FH-raidonn/LR_Furukawa/README.md

LR_Workのフォルダ内にRDACのデータが入っています。
末尾の数字が多いほうが最新版です

現在の最新版(LR_Work5/RDAC_0128)
