FH-raidonn/LR_Furukawa/LR_Work3/Report_1003/ミニマルアルバイト課題_目標値追記_Furukawa.pptx

9月度アルバイト内容
１．(抵抗ラダー、キャパシタタイプ14bitDAC)+ボルテージフォロアーアンプ回路設計、シミュレーション
TOOL：回路設計⇒Xschem or LTSPICE、シミュレーション⇒NGSPICE or LTSPICE
目標仕様：変換速度 10MSPS
SPICEモデル：N3(3V Nch), P3(3V Pch)
抵抗情報:2kΩ/um²　or 350Ω/um² ,0.08fF/um²
キャパシター情報:1.32ff/um², 80Ω/um²
納品物：Xschemのデータとシミュレーション報告書(フォーマットは、自由)及びデータシート
納期：10月3日
担当者：野田さん、古川さん

入力・出力信号情報
VDD:3.3V±10%、VSS:0V
VREFH:VDD、Vrefl:VSS、入力範囲:VSS～VDD
DIN[13:0]:VIL=VDDx0.2, VIH=VDD*0.8, trise=tfall=1ns
DACO=(Vrefh-Vrefl)/16384 x din(バイナリ値)
PD:PD=VILでパワーダウンモード
Iref:10uAのバイアス電流源
VOUT:DACOをボルテージフォロアアンプを経由した出力
din⇒dout出力遅延時間:90ns max
vm=VDD/16384
【タイムチャート】以下参照

din[14’h0000]

din[14’h3fff]

din[14’h1fff]

din[14’h0fff]

din[14’h1111]

不定

dout=0

不定

dout=VDD

不定

dout=vm*8192

不定

dout=vm*4096

不定

dout=vm*4369

<90ns

100ns

<90ns

100ns

<90ns

100ns

<90ns

100ns

<90ns

100ns

## Slide 2

データシートのフォーマット

DAC部(VDD=3.3V, VSS=0V)
項目 | Symbol | 条件 | | 目標値 | typ | ワースト | 単位
INLエラー | INL | データ=x0000-x3ffff | | ±2 | +1.26 | | LSB
DNL | DNL | データ=x0000-x3ffff | | ±1 | +1.61 | | LSB
オフセットエラー | Vos | VIN=0x0000 | | 5 | ほぼ0% | | %of FSR
Gain エラー | gE | VIN=0x3fff | | 5 | 0.05 | | %of FSR
消費電流 | IDD | VIN=0x3FFF, PD=VIH, f=10MHz* | | 5 | 0.108 | | mA
スタンバイ電流 | IDDS | PD=VIL | | 100 | 26.181 | | uA
ボルテージフォロワーアンプ部(VDD=3.3V, VSS=0V)
出力電圧範囲 | VOUT | | VREFH-VREFL | | 59.9n~3.16 | | V
位相裕度 | Φ | | 90 | | 33.8 | | °
Slew Rate | SR | RL=1MΩ, CL=1pF | 0.1 | | 2.29 | | V/us
出力電流 | IOUT | CL=1pF | 1 | | 0.78 | | mA

ブロック図

f=DINのサイクル周波数

抵抗ラダー、キャパシタタイプ DAC

ボルテージフォロワーアンプ

DIN[13:0]

DACO

+

VOUT

Ibias

PD
