FH-raidonn/LR_Furukawa/LR_Work4/Review_1112/RDAC報告_1112.pptx

## RDAC 10月分

古川 大鷹

## Slide 2

10月度アルバイト内容
１．(抵抗ラダー、キャパシタタイプ12bitDAC)+ボルテージフォロアーアンプ回路設計、シミュレーション
TOOL：回路設計⇒Xschem or LTSPICE、シミュレーション⇒NGSPICE or LTSPICE
目標仕様：変換速度 10MSPS(最悪 5MSPS)
SPICEモデル：N3(3V Nch), P3(3V Pch)
抵抗情報:2kΩ/um²　or 350Ω/um² ,0.08fF/um²
キャパシター情報:1.32ff/um², 80Ω/um²
納品物：Xschemのデータとシミュレーション報告書(フォーマットは、自由)及びデータシート
納期：10月31日
担当者：野田さん、古川さん

入力・出力信号情報
VDD:3.3V±10%、VSS:0V
VREFH:VDD、Vrefl:VSS、出力範囲:VSS+0.7～VDD-0.7
DIN[11:0]:VIL=VDD*0.2, VIH=VDD*0.8, trise=tfall=1ns
DACO=(Vrefh-Vrefl)/4096 x din(バイナリ値)
PD:PD=VILでパワーダウンモード
Iref:±10uAのバイアス電流源
VOUT:DACOをボルテージフォロアアンプを経由した出力
din⇒dout出力遅延時間:90ns max
vm=出力範囲/4096
【タイムチャート】以下参照

9月の課題からの変更点
・DACのビット数（14→12)
・出力範囲（Rail to Rail→緩和）
・変換速度の最悪値

din[12’h0000]

不定

dout=0

din[12’hf1ff]

不定

dout=vm*1ff

din[12’hfff]

不定

dout=vm*fff

din[12’h0ff]

不定

dout=vm*0ff

din[12’h111]

不定

dout=vm*111

<90ns

100ns

<90ns

100ns

<90ns

100ns

<90ns

100ns

<90ns

100ns

## Slide 3

データシートのフォーマット

DAC部(VDD=3.3V, VSS=0V)
項目 | Symbol | 条件 | | 目標値 | typ | ワースト | 単位
INLエラー | INL | データ=x000-xfff | | ±2 | | | LSB
DNL | DNL | データ=x000-xfff | | ±1 | | | LSB
オフセットエラー | Vos | VIN=x000 | | 5 | | | %of FSR
Gain エラー | gE | VIN=xfff | | 5 | | | %of FSR
消費電流 | IDD | VIN=xfff, PD=VIH, f=10MHz* | | 5 | | | mA
スタンバイ電流 | IDDS | PD=VIL | | 100 | | | uA
ボルテージフォロワーアンプ部(VDD=3.3V, VSS=0V)
出力電圧範囲 | VOUT | | ** | | | | V
位相裕度 | Φ | | 90 | | | | °
Slew Rate | SR | RL=1k, Vout=2VPP | 20 | | | | V/us
出力電流 | IOUT | CL=1pF | 1 | | | | mA

*:f=DINのサイクル周波数, **: :VSS+0.7～VDD-0.7

ブロック図

9月の課題からの変更点
・DACのビット数（14→12)
・出力範囲（Rail to Rail→緩和）

抵抗ラダー、キャパシタタイプ DAC

ボルテージフォロワーアンプ

DIN[13:0]

DACO

+

VOUT

PD

IrefSink
IrefSource

/2

## DAC全体の回路図

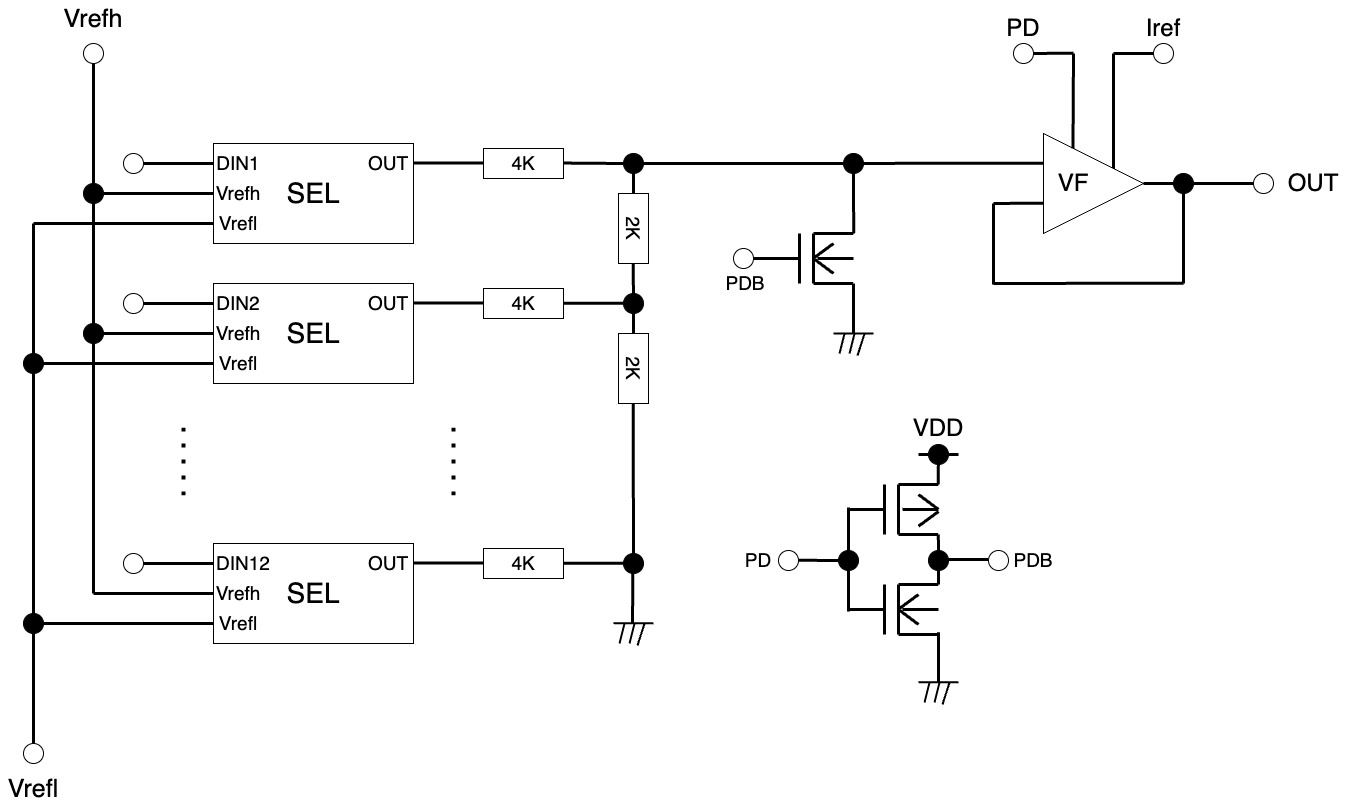
[picture p20: figure]
ダイアグラム, 概略図 AI 生成コンテンツは誤りを含む可能性があります。

## セレクタの回路図

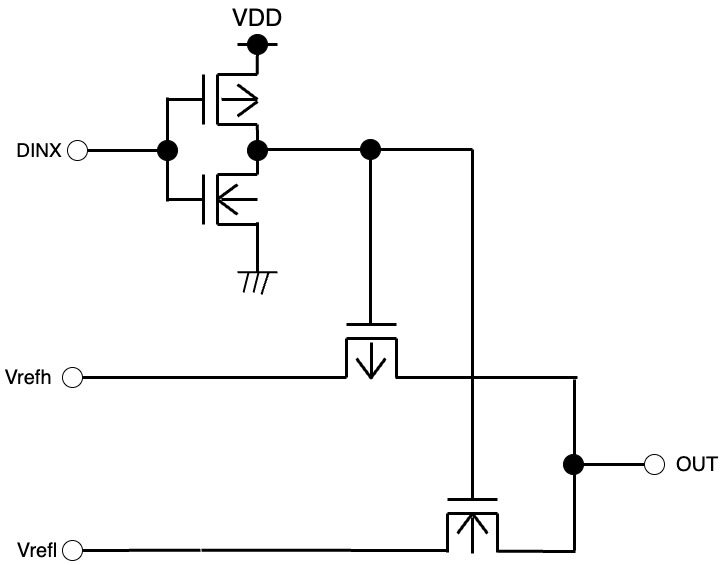
[picture p21: figure]
ダイアグラム, 概略図 AI 生成コンテンツは誤りを含む可能性があります。

## ボルテージフォロワ

・出力範囲電圧
・位相余裕
・スルーレート
・出力電流

## ボルテージフォロワの回路図

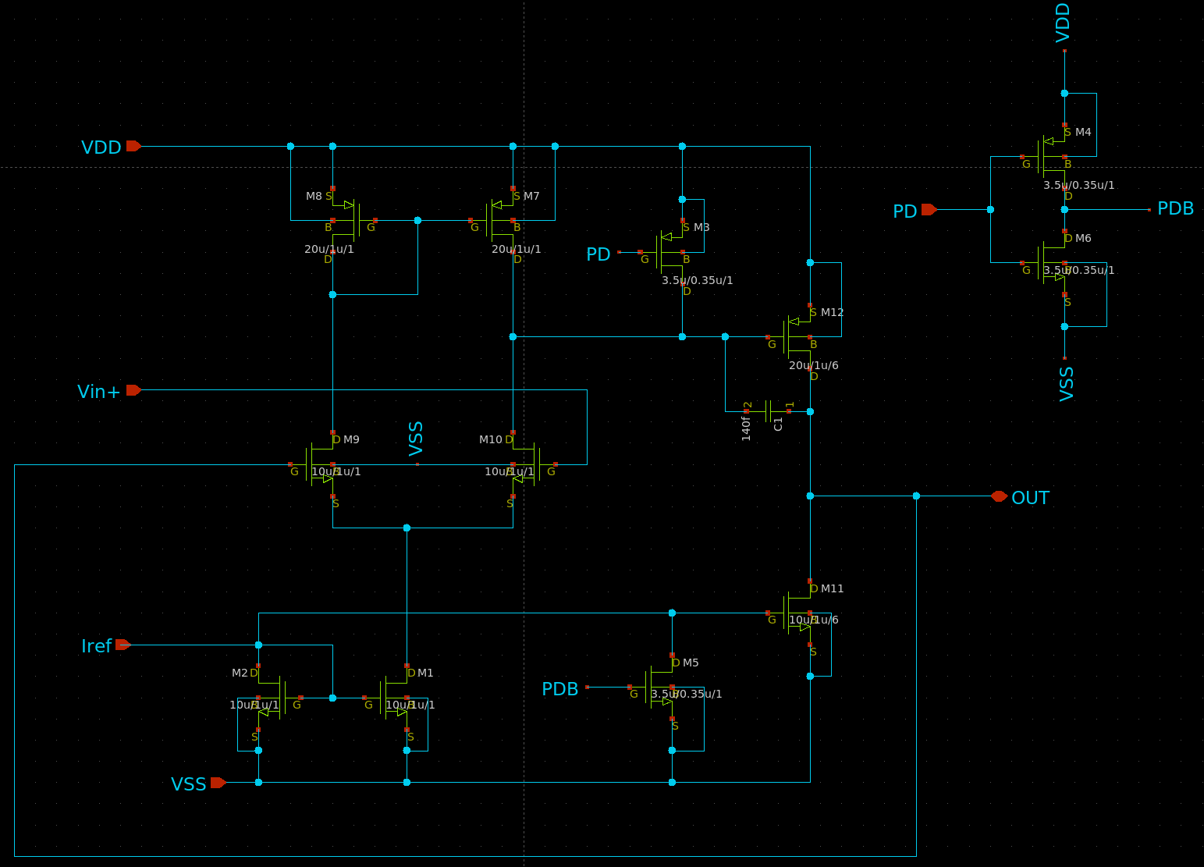
[picture p22: figure]

位相補償容量：140f[F]
オペアンプ部のMOSの寸法
nMOS：W=10um
pMOS：W=20um
L(共通) = 1um

ソース接地回路のMOSはm=6

PD部のMOSの寸法
W(共通) = 3.5um
L(共通) = 0.35um

m=6

## 出力電圧範囲

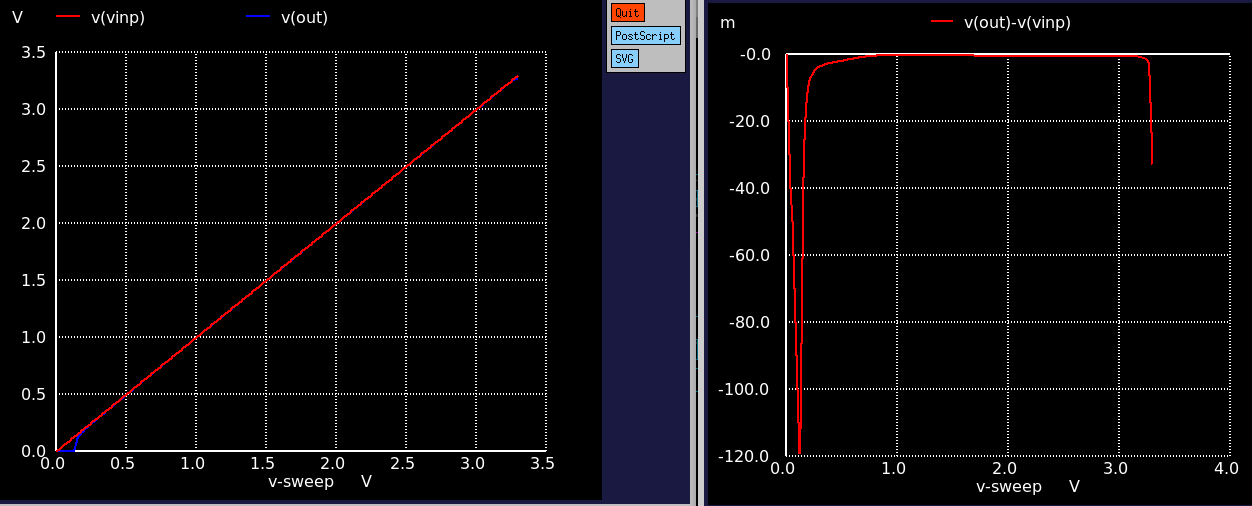
[picture p23: figure]

出力電圧範囲：0.33V～3.26V
(理論値との誤差の許容範囲が1%とすると)

## 出力電圧範囲

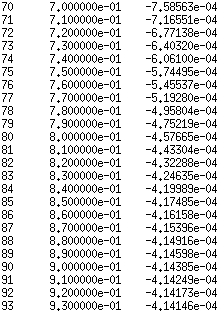
[picture p24: figure]
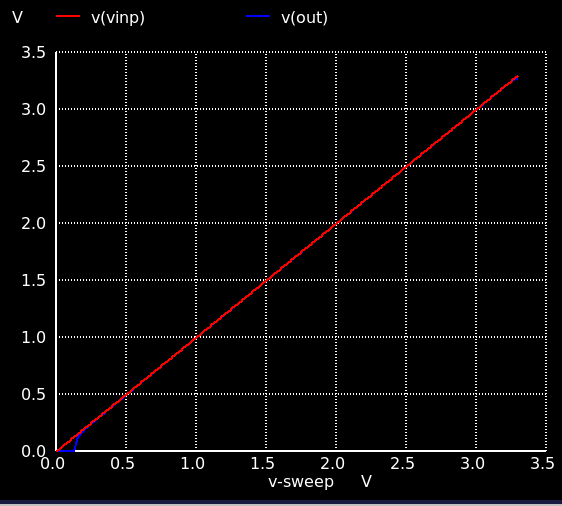
[picture p25: figure]
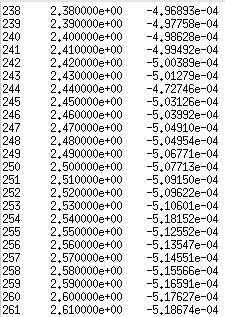
[picture p26: figure]

DACの仕様を満たす範囲には収まらなかった
(0.7V～2.6Vの間で、傾き1の理想直線から±1/2LSB(0.232mV)に
収まるようにする)
VFとして動作はするが、DAC本体の出力部との誤差が大きくなる

## 位相余裕

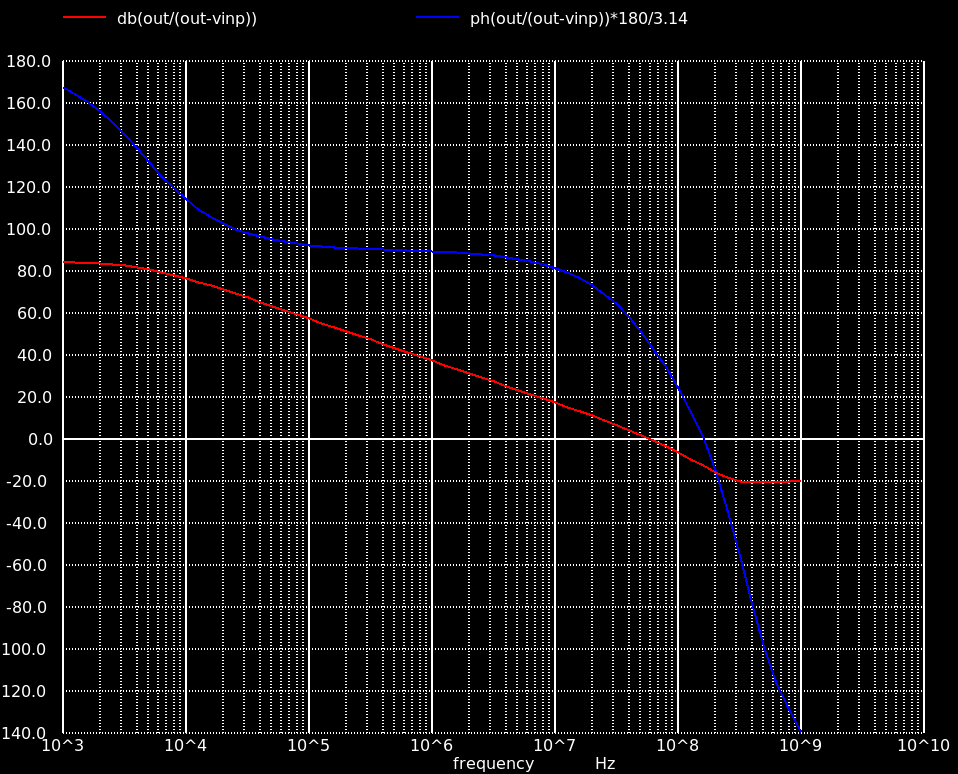
[picture p27: figure]

位相補償キャパシタ：140f[F]
位相余裕：45°程度

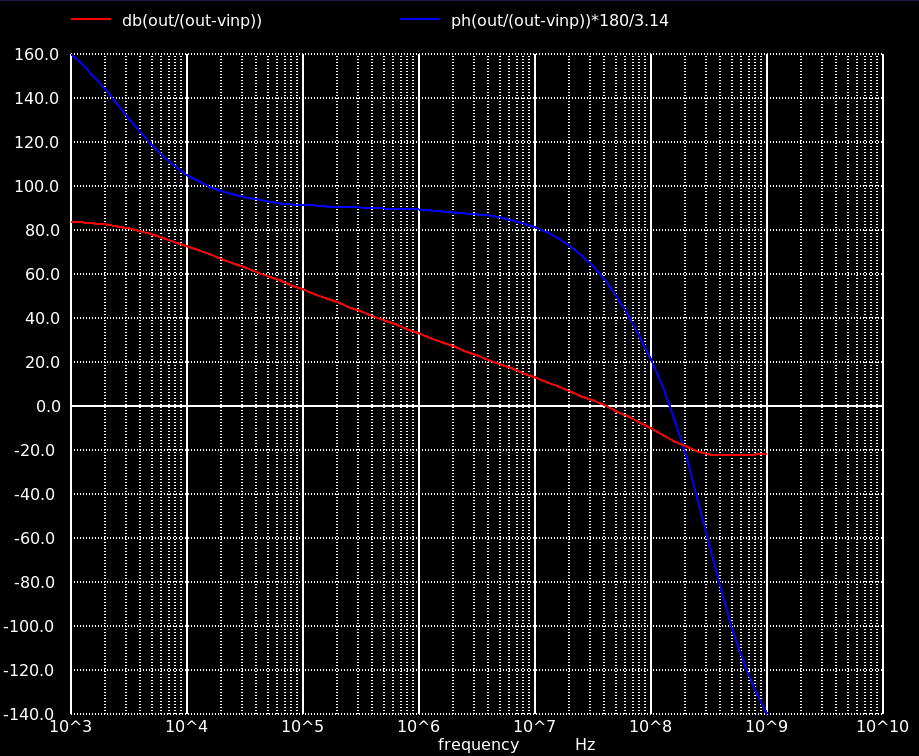
[picture p28: figure]

位相補償キャパシタ：256f[F]
位相余裕：56°程度

## スルーレート

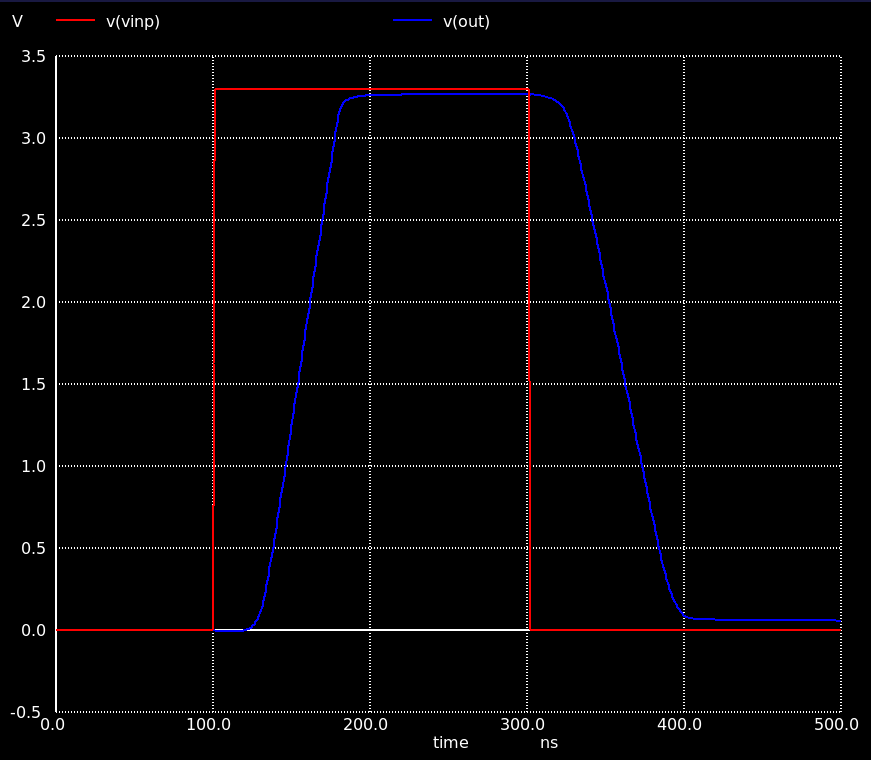
[picture p29: figure]

位相補償容量：140f[F]

立ち上がり
(2.97−0.33)/(0.0419us) = 63.01[V/us]

立ち下がり
(2.97−0.33)/(0.0575us) = 45.91[V/us]

## 出力電流

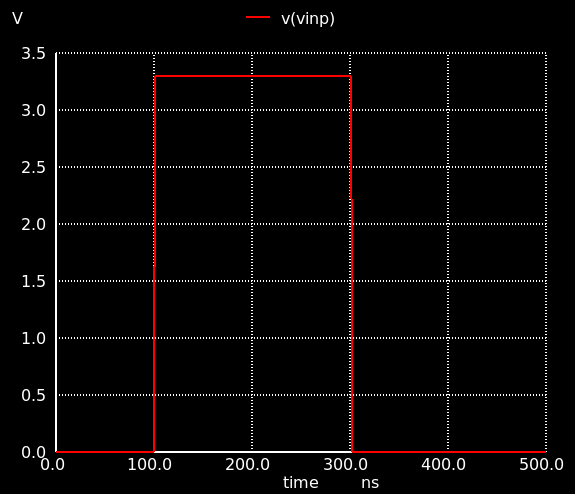
[picture p30: figure]

下記のパルス波を入力したときの
電流値を見る
(立ち上がり・立ち下がり時間は
共に1ns)
負荷容量：1p[F]

## 出力電流

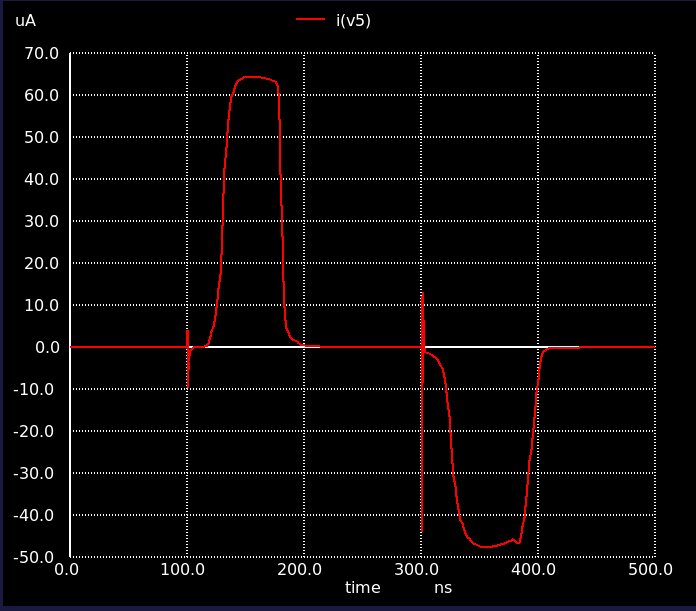
[picture p31: figure]

立ち上がり時のピーク電流：64.42[uA]
立ち下がり時のピーク電流：-47.60[uA]

## RDAC部+ ボルテージフォロワ

赤枠：12bitRDAC
青枠：ボルテージフォロワ

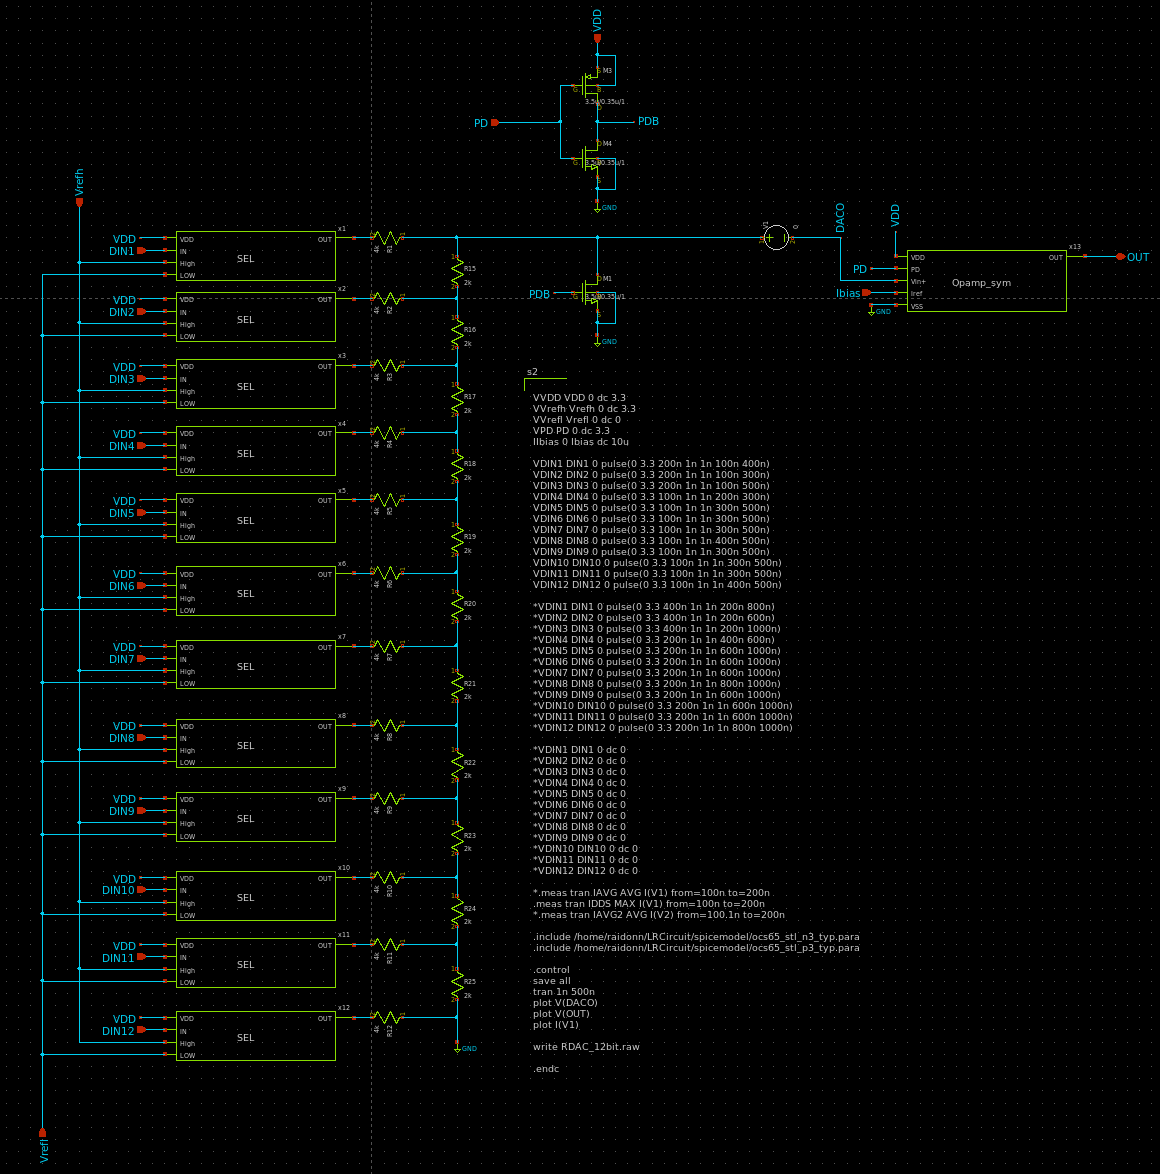
[picture p32: figure]

## RDAC+VFのシミュレーション結果

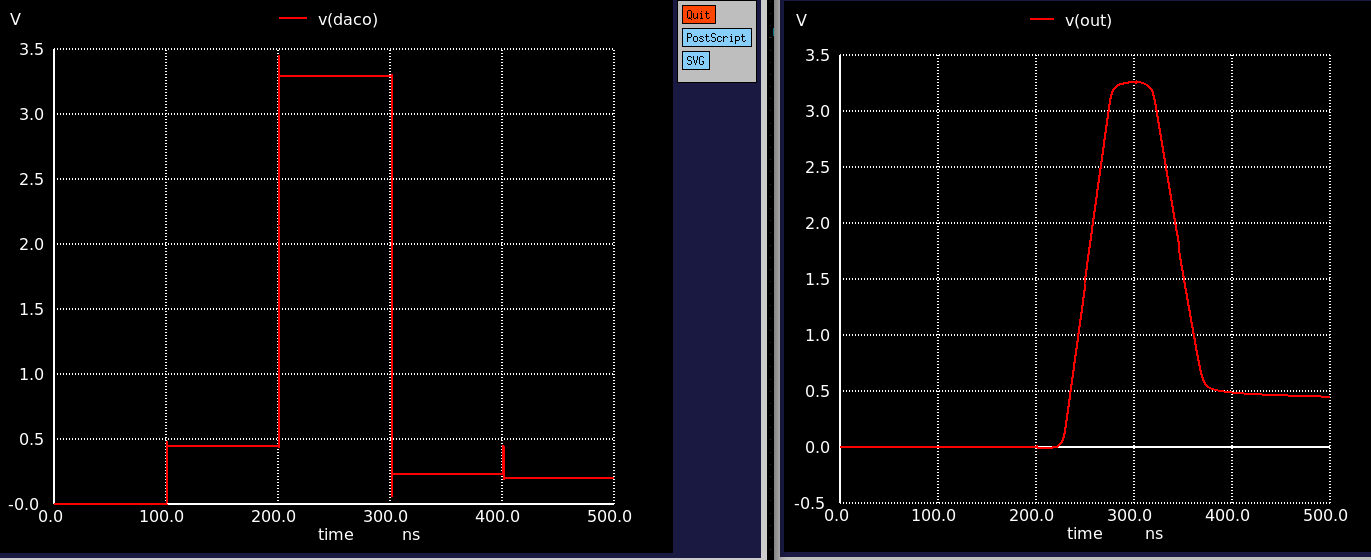
[picture p33: figure]

前回の報告よりはVFのスルーレートもあがり、DAC部に追尾するようになった
後段のサンプルホールド回路のサンプリングのウィンドウ幅の規定が必要か？

## オフセットエラー

VIN=0x000

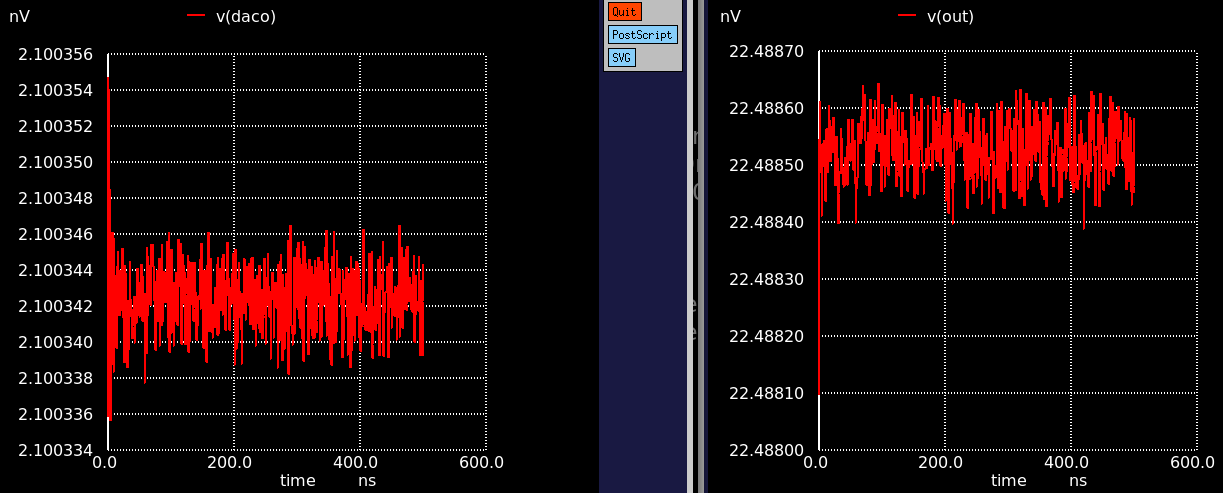
[picture p34: figure]

DAC部 平均値：2.100[nV]

VF部 平均値：22.49[nV]

誤差：0.00000021% (DAC部) (ほぼ0%)
0.00000224% (VF部) (ほぼ0%)

## ゲインエラー

VIN=0xfff

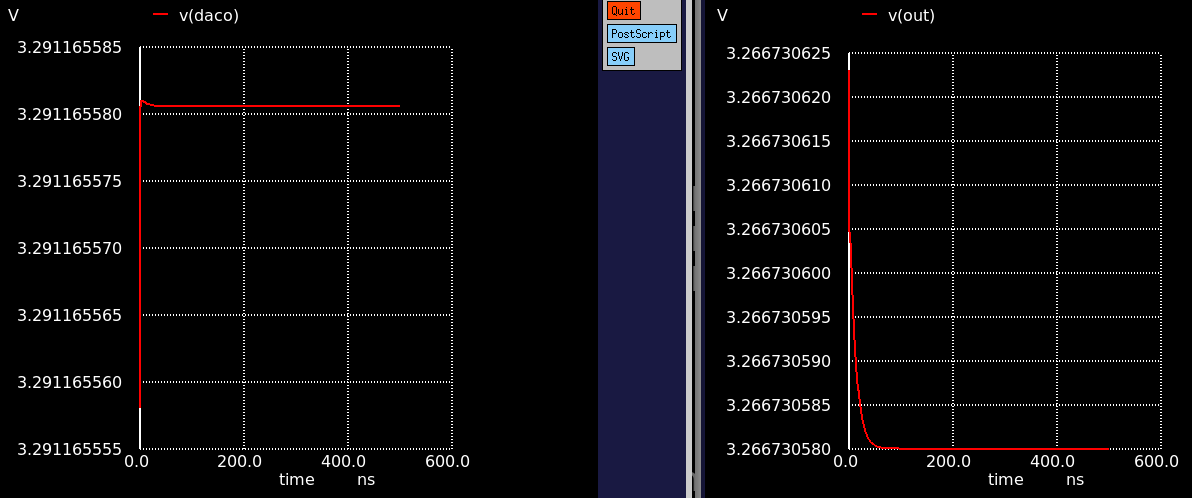
[picture p35: figure]

DAC部 平均値：3.291[V]

VF部 平均値：3.267[V]

誤差：0.273% (DAC部)
1% (VF部)

## 消費電流

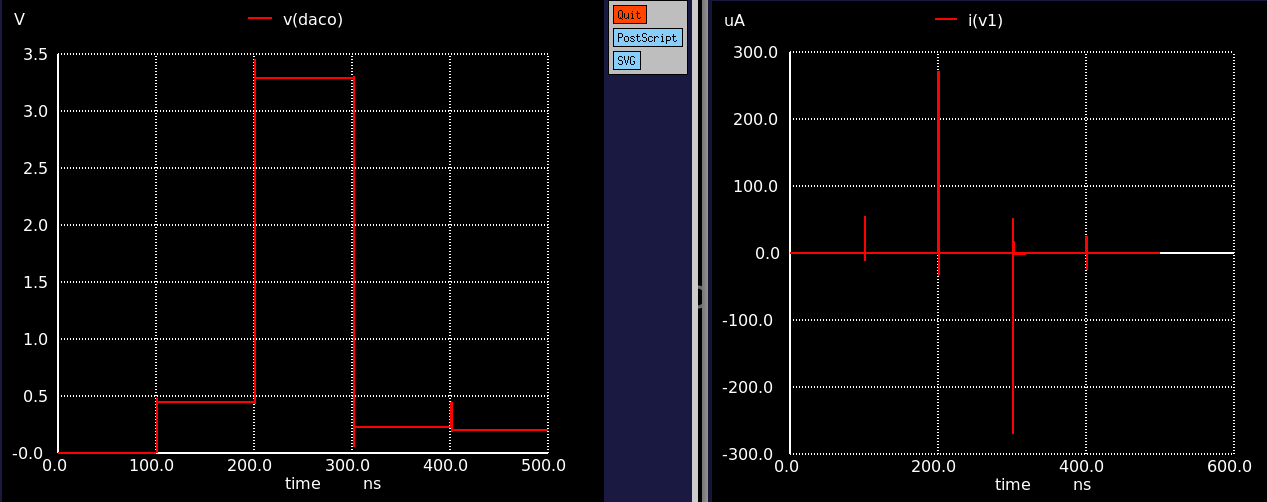
[picture p36: figure]

DAC出力の200n~300nを測定(VIN=0xfff, PD=VIH)

ピーク電流：0.272[mA]
平均消費電流：0.370[uA]

## スタンバイ電流

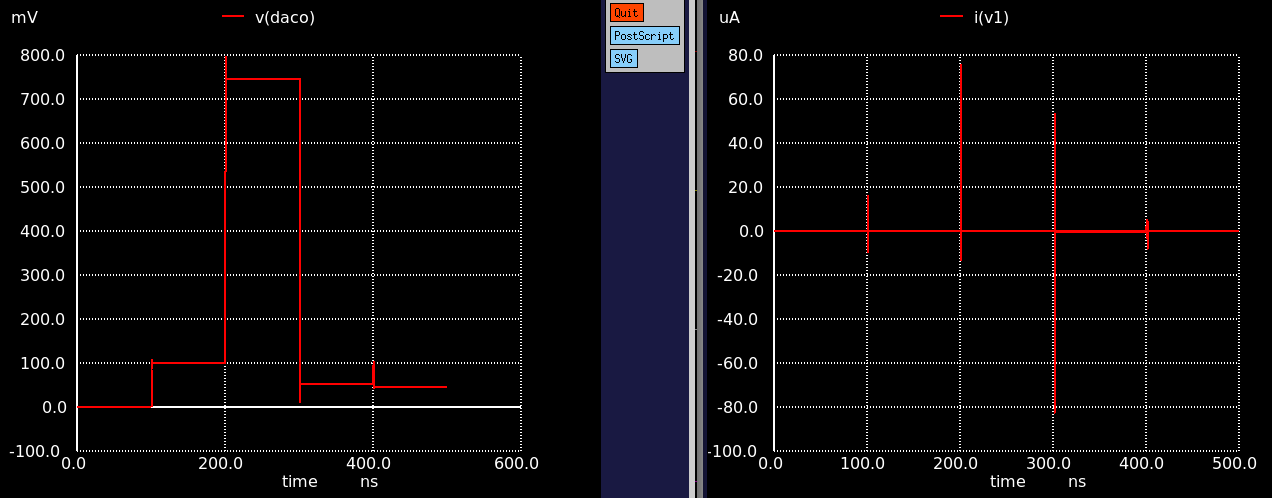
[picture p37: figure]

DAC出力の200n~300nを測定(VIN=0xfff, PD=VIL)

ピーク電流：75.74[uA]
平均消費電流：0.106[uA]

## Slide 20

データシートのフォーマット

DAC部(VDD=3.3V, VSS=0V)
項目 | Symbol | 条件 | | 目標値 | typ | ワースト | 単位
INLエラー | INL | データ=x000-xfff | | ±2 | | | LSB
DNL | DNL | データ=x000-xfff | | ±1 | | | LSB
オフセットエラー | Vos | VIN=x000 | | 5 | ほぼ0% | | %of FSR
Gain エラー | gE | VIN=xfff | | 5 | 0.273% | | %of FSR
消費電流 | IDD | VIN=xfff, PD=VIH, f=10MHz* | | 5 | 0.272 | | mA
スタンバイ電流 | IDDS | PD=VIL | | 100 | 75 | | uA
ボルテージフォロワーアンプ部(VDD=3.3V, VSS=0V)
出力電圧範囲 | VOUT | | ** | | 0.33～3.26 | | V
位相裕度 | Φ | | 90 | | 56 | | °
Slew Rate | SR | RL=1k, Vout=2VPP | 20 | | 63.01 | | V/us
出力電流 | IOUT | CL=1pF | 1 | | 0.064 | | mA

*:f=DINのサイクル周波数, **: :VSS+0.7～VDD-0.7

ブロック図

9月の課題からの変更点
・DACのビット数（14→12)
・出力範囲（Rail to Rail→緩和）

抵抗ラダー、キャパシタタイプ DAC

ボルテージフォロワーアンプ

DIN[11:0]

DACO

+

VOUT

PD

IrefSink
IrefSource

/2

## まとめ (1/2)

・オペアンプの寸法を見直し、スルーレートをはじめ特性が
大幅に向上した
→ 余裕を持たせるためにもう少しスルーレートが必要かも？
・INLとDNLは後日検証します

## まとめ (2/2)

DAC部後段のサンプルホールド回路について
→サンプルホールド回路で行うサンプリングの
ウィンドウ幅の規定があるかどうかという懸念がある

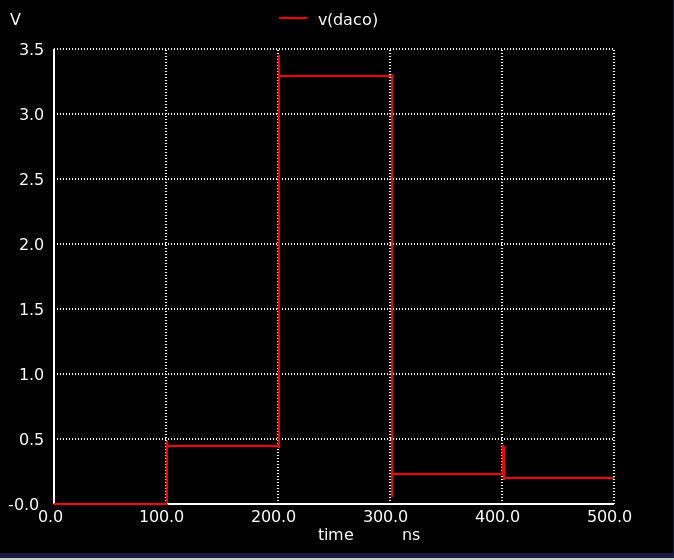
[picture p38: figure]

例えば、右の波形の200ns時点でサンプリングをすると、VDDの値を超えた数値が後段の
コンパレータに入力されることになる

## Slide 23

今回の回路を使ったADCの構造

抵抗ラダー、キャパシタタイプ DAC

ボルテージフォロワーアンプ

RST
INP
INN

クロックドコンパレータ

ラッチ

DIN[11:0]

DACO

+

OUT_DAC
(モニター)

DACO1

RST
D Q
CLK XQ
PD

COMPOへ

PD

IrefSink
IrefSource

ADIN

/2

PD

IrefSink
IrefSource

clk

/2

din[12’h0000]

din[12’hf1ff]

din[12’hfff]

din[12’h0ff]

din[12’h111]

DACの
タイムチャート

不定

dout=0

<90ns

不定

dout=vm*1ff

<90ns

不定

dout=vm*fff

<90ns

不定

dout=vm*0ff

<90ns

不定

dout=vm*111

<90ns

100ns

100ns

100ns

100ns

100ns

上記のタイムチャートで、dinを切り替えたタイミングから90nsは出力が不定
90nsから100nsの間でサンプリングを行うという解釈であっているか
