FH-raidonn/LR_Furukawa/LR_Work2/LR課題2_Furukawa.pptx

## LR アルバイト課題2

東海大学 情報通信学研究科
古川 大鷹

使用ツール：xschem
ngspice

## 課題内容

抵抗ラダー、キャパシタタイプ14bitDAC回路設計、シミュレーション

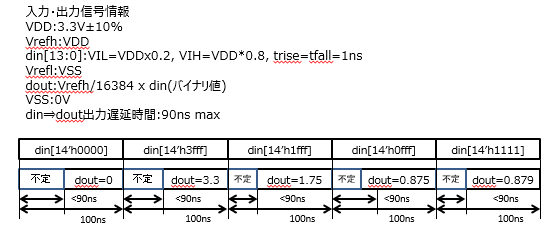
[picture p66: figure]

回路の仕様

## 抵抗ラダー型 14ビットDACの回路図

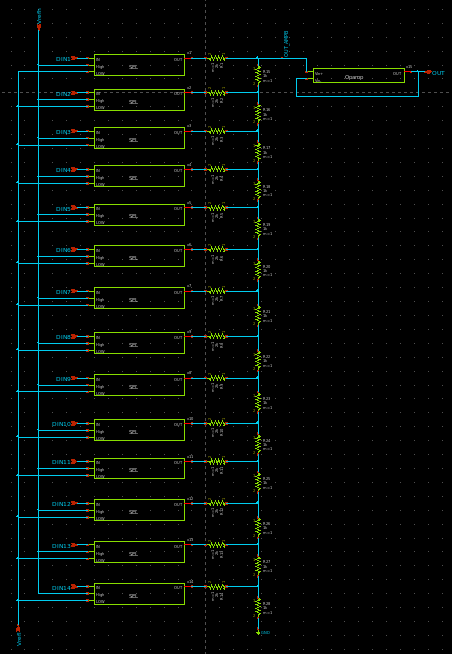
[picture p67: figure]

DIN1

DIN14

入力信号：DIN1～DIN14
出力信号：OUT
赤枠：入力信号によって V_(DD) [V] or 0[V]を
出力するセレクタ群
青枠：抵抗ラダー群(R-2R型)
橙枠：出力部(オペアンプは未完成)

## 抵抗ラダー型14ビットDACの回路図


セレクタの回路図

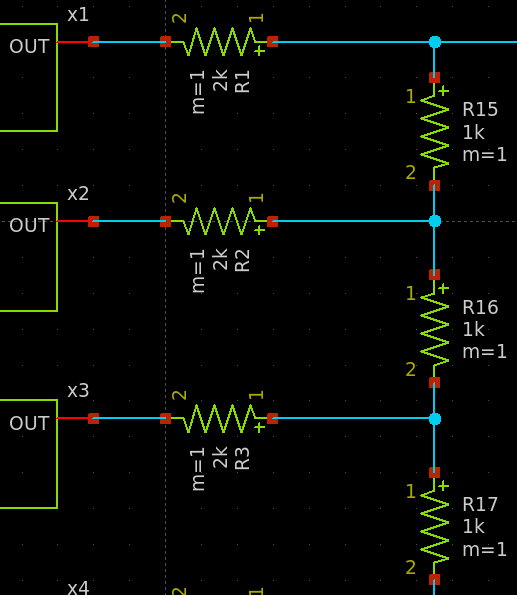
[picture p68: figure]

抵抗ラダー群, 縦：横 = 1：2で設計

## シミュレーション結果

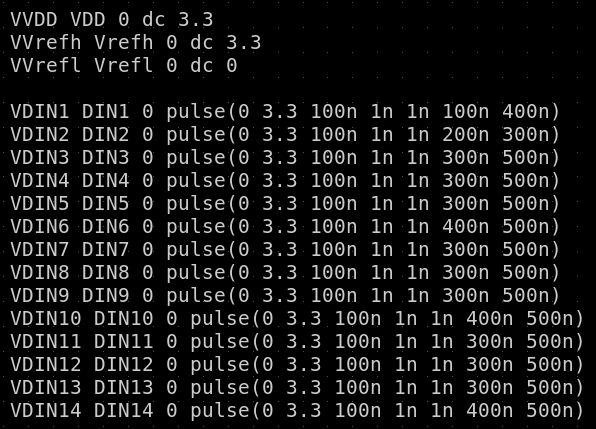
[picture p69: figure]
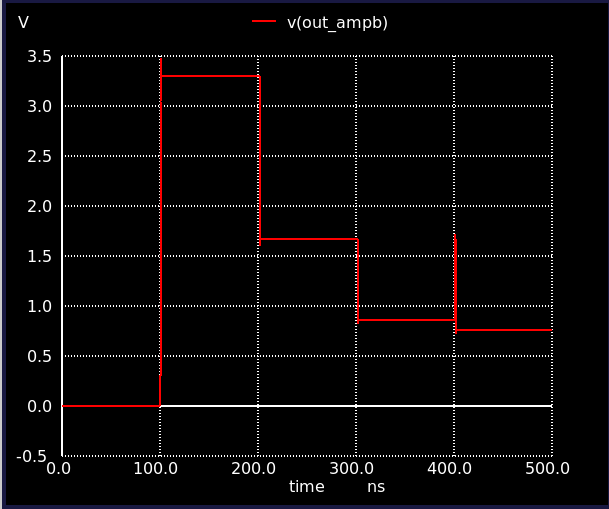
[picture p70: figure]

入力信号

出力信号

## シミュレーション結果

DIN1
～

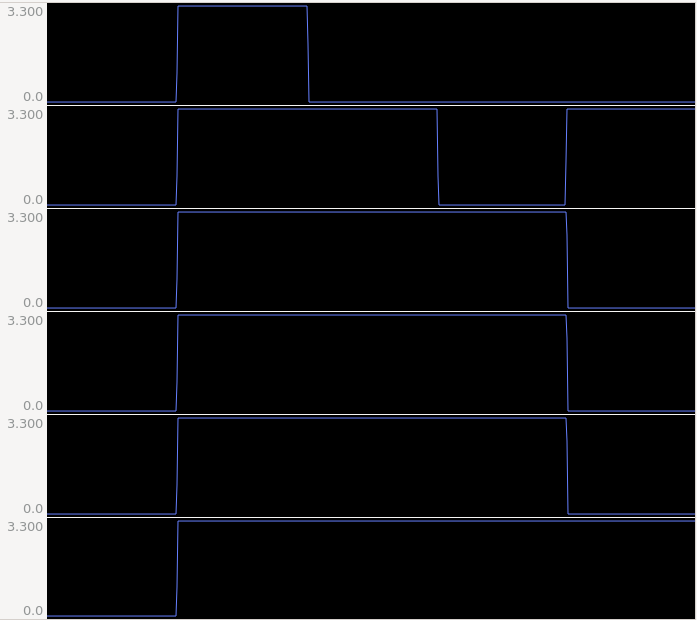
[picture p71: figure]

0[V]

3.3[V]

1.67[V]

0.861[V]

0.765[V]

DIN6

DIN7
～

DIN10

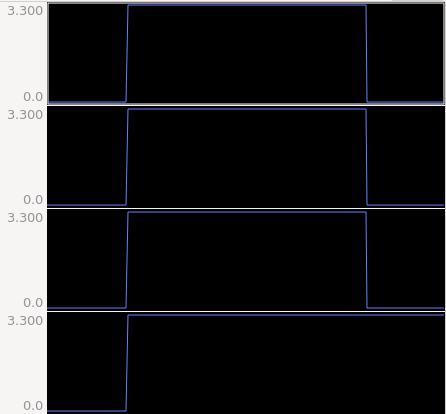
[picture p72: figure]

DIN11
～

DIN14

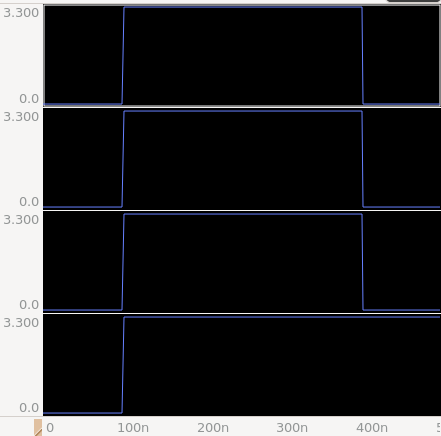
[picture p73: figure]

概ねDACとしての動作は得られたが、配線による減衰の影響で理論値とは多少異なる結果となった
